LeftistTachyon/BinauralMic/README.md

# Tachi's Homemade Binaural Mic
More to come soon!  
(I barely have a schematic atm lol)
