LeftistTachyon/BinauralMic/binauralmic.3dmodels/2-1977223-4.stp

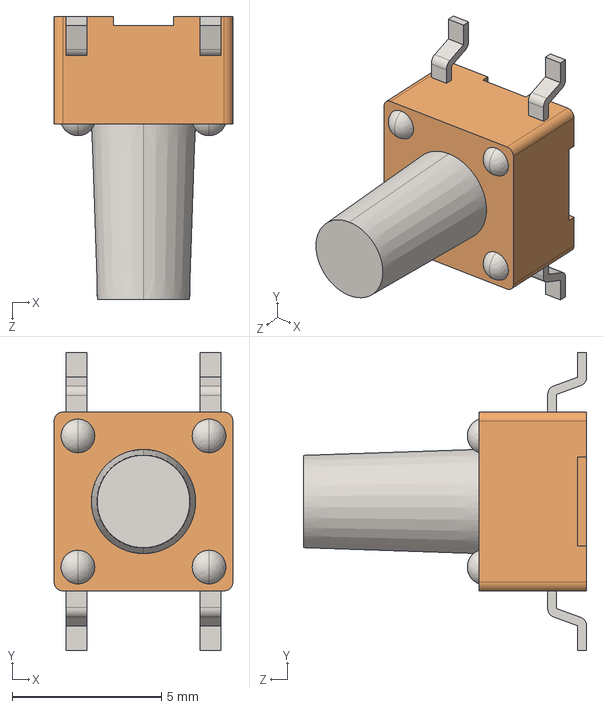
[picture p1: CAD file, 2025-07-08]
binauralmic.3dmodels/2-1977223-4.stp
6.00 x 10.0 x 9.51 mm
