LeftistTachyon/BinauralMic/BinauralMic.step

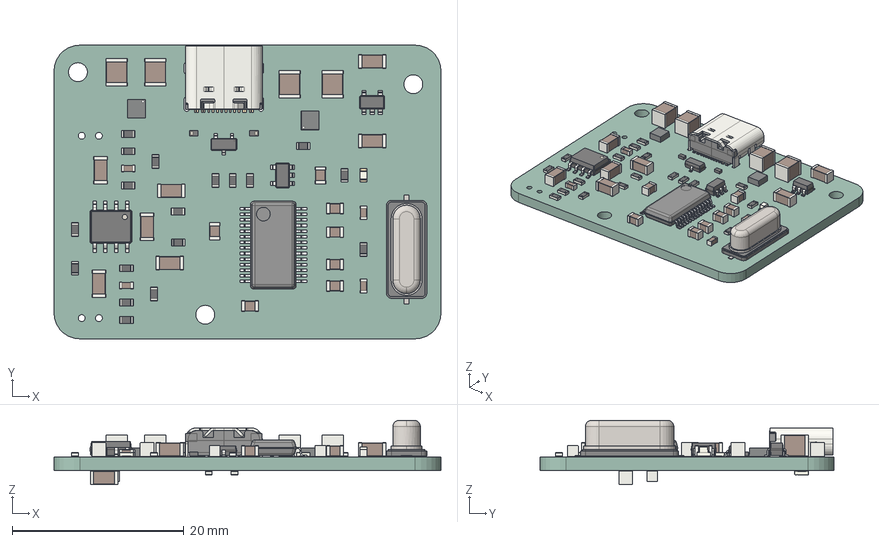
[picture p2: CAD file, 2024-10-13]
BinauralMic.step
45.0 x 34.2 x 7.50 mm
ABLS-12.000MHZ-B4-T
C_1206_3216Metric x 8
C_0805_2012Metric x 8
C_0603_1608Metric x 4
R_0603_1608Metric x 20
C_1210_3225Metric x 4
SOT_23_5 x 2
SOIC_8_39x49mm_P127mm
Coilcraft-XFL2010 x 2
LED_0603_1608Metric
D_SOD-882 x 2
USB_C_Receptacle_16P_TopMnt_Horizontal_GCT_USB4105-xx-A
DB0028A_ASM
SOT-23-3
BinauralMic_PCB
