LeftistTachyon/BinauralMic/binauralmic.3dmodels/ABLS-12.000MHz-20-D-3-H-T.stp

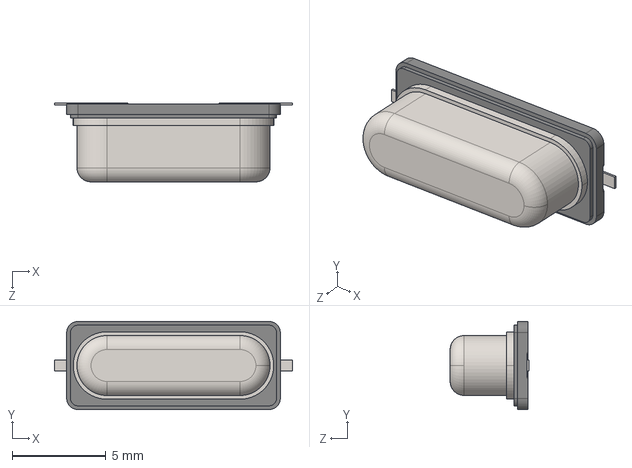
[picture p3: CAD file, 2024-09-22]
binauralmic.3dmodels/ABLS-12.000MHz-20-D-3-H-T.stp
12.7 x 4.70 x 4.20 mm
