LeftistTachyon/BinauralMic/binauralmic.3dmodels/CUI_DEVICES_RCJ-014.step

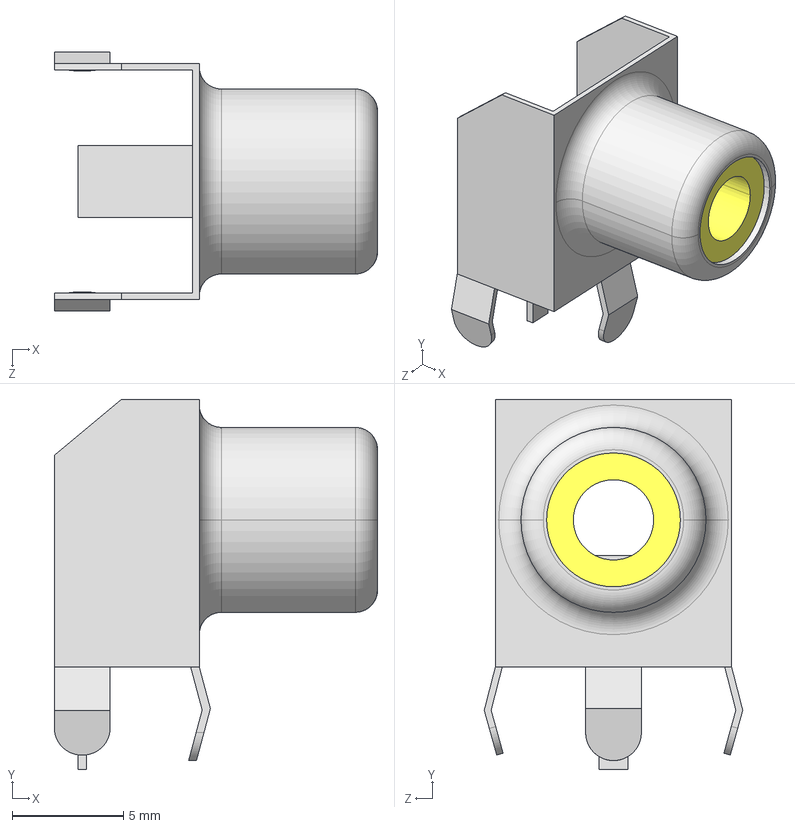
[picture p4: CAD file, 2024-09-21]
binauralmic.3dmodels/CUI_DEVICES_RCJ-014.step
14.5 x 16.6 x 11.6 mm
