LeftistTachyon/BinauralMic/binauralmic.3dmodels/Coilcraft-XFL2010.step

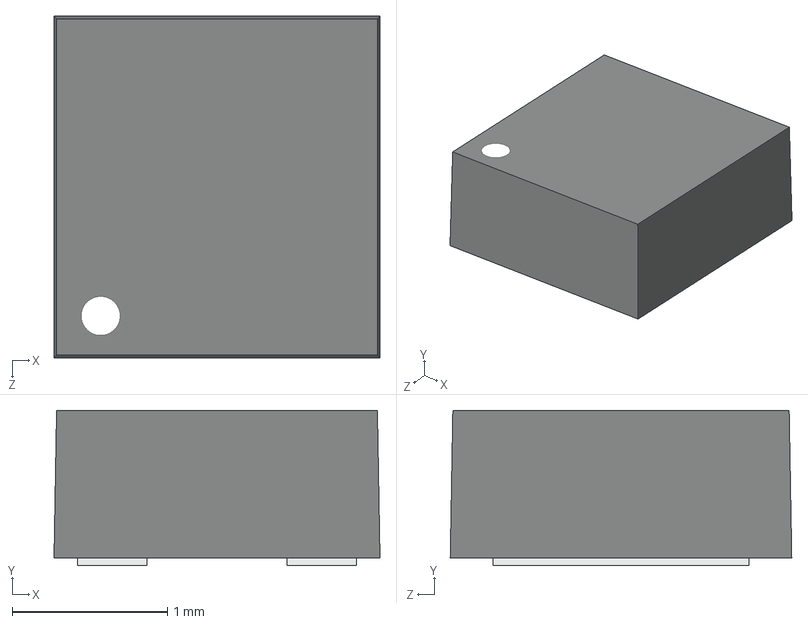
[picture p5: CAD file, 2024-09-16]
binauralmic.3dmodels/Coilcraft-XFL2010.step
2.10 x 1.00 x 2.20 mm
