LeftistTachyon/BinauralMic/binauralmic.3dmodels/P140KH1-Y20AR20K.stp

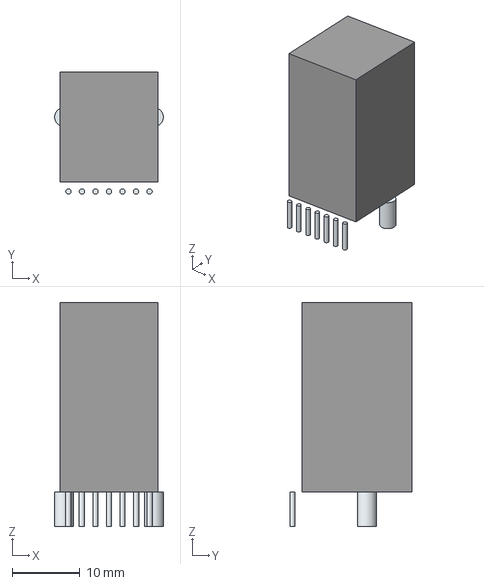
[picture p6: CAD file, 2024-09-16]
binauralmic.3dmodels/P140KH1-Y20AR20K.stp
16.1 x 18.1 x 33.1 mm
Leads
