LeftistTachyon/BinauralMic/binauralmic.3dmodels/MX1A-11NW.stp

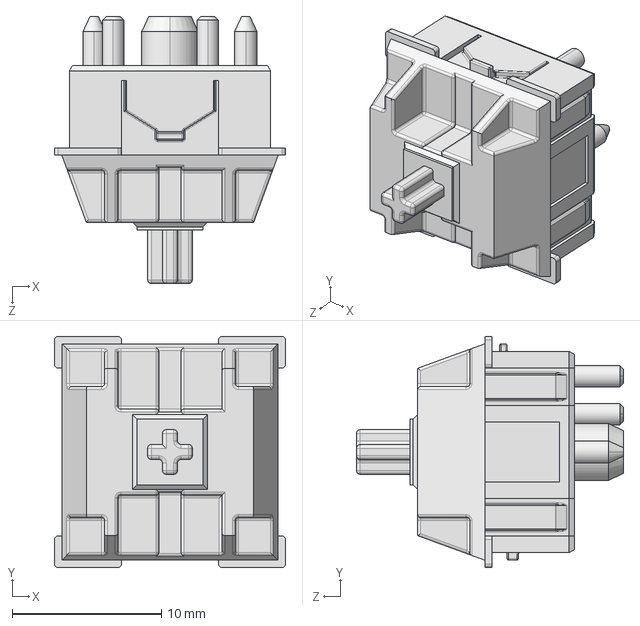
[picture p7: CAD file, 2024-09-15]
binauralmic.3dmodels/MX1A-11NW.stp
15.5 x 15.5 x 17.9 mm
