LeftistTachyon/BinauralMic/binauralmic.3dmodels/ECS-120-8-36-CKM-TR3.stp

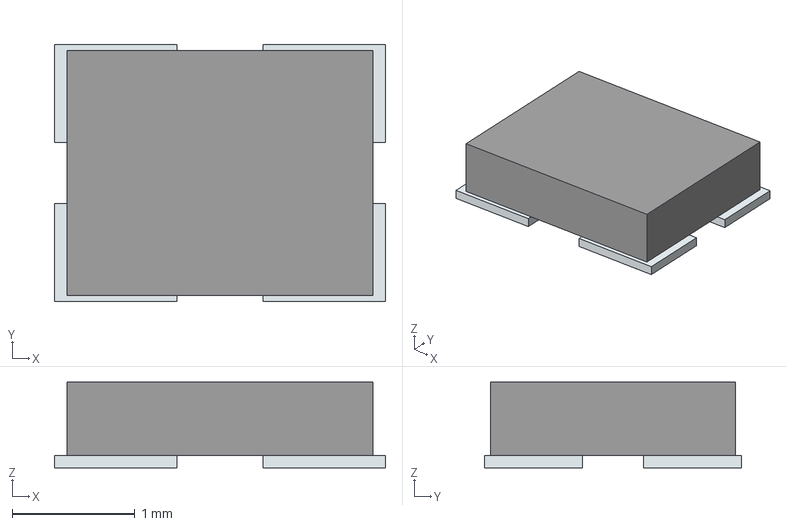
[picture p8: CAD file, 2024-09-13]
binauralmic.3dmodels/ECS-120-8-36-CKM-TR3.stp
2.70 x 2.10 x 0.7 mm
Pins
