LeftistTachyon/BinauralMic/binauralmic.3dmodels/PCM2903CDBR.stp

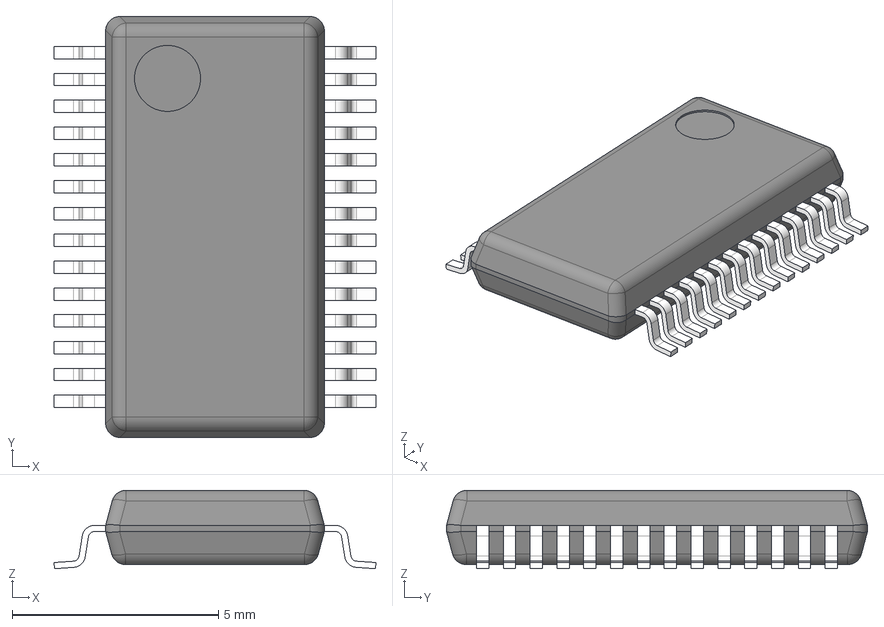
[picture p9: CAD file, 2024-09-13]
binauralmic.3dmodels/PCM2903CDBR.stp
7.80 x 10.2 x 1.90 mm
BODY-SSOP
LEAD-SSOP x 28
PIN1
