LeftistTachyon/BinauralMic/sim/Preamp2.asc

C1: cap; 68p
C2: cap; 4.7µ; Rser={ESR}
C3: cap; 4.7µ
C4: cap; 4.7µ; Rser={ESR}
I1: current; SINE(0.5m 28.68e-6 1k); AC 28.68e-6
R1: res; {Rpot}
R2: res; 1Meg
R3: res; 49.9
R4: res; 100k
R5: res; 100k
R6: res; 100k
R7: res; 11.111k
R8: res; 2.2k
R9: res; 5.9k
R10: res; 1m
U1: UniversalOpAmp2
V1: voltage; 3.3
V2: voltage; 5
Named nets: 0, 3V3, VB, IN, N, O, OUT
.ac dec 1k 2 200Meg
.tran 10m
.noise V(OUT) I1 dec 1k 2 200k
;.step param ESR list 0 4
.param ESR=4
.step param Rpot 1 20k 2k
