LeftistTachyon/BinauralMic/sim/InputFilter.asc

C1: cap; 22µ
C2: cap; 23µ
L1: ind; 47µ; Rser=2.53
V1: voltage; ""; AC 1
Named nets: 0, IN, OUT
.ac dec 1k 47k 49k
