LeftistTachyon/BinauralMic/sim/Preamp.asc

C1: cap; 330p
C2: cap; 0.0018µ
C3: cap; 10µ
C4: cap; 10µ
R1: res; 3.9k
R2: res; 12k
R3: res; 12k
R4: res; 100
R5: res; {Rin}
U1: UniversalOpAmp2
V1: voltage; PULSE(0 3.3 100u 10u 10u 200u 500u 2); AC 1
V2: voltage; 3.3
V3: voltage; 1.65
Named nets: 0, 3V3, IN, OUT, OUT_RAW, IN_RAW, N1, N2, N3
.ac dec 1k 10 10Meg
.ac dec 1k 0.1 1k
;.step param Rin list 10 1k 10k 100k
.param Rin=1Meg
.tran 1m
