LeftistTachyon/BinauralMic/BinauralMic.kicad_pcb

## KiCad design BinauralMic.kicad_pcb (2025-07-08)

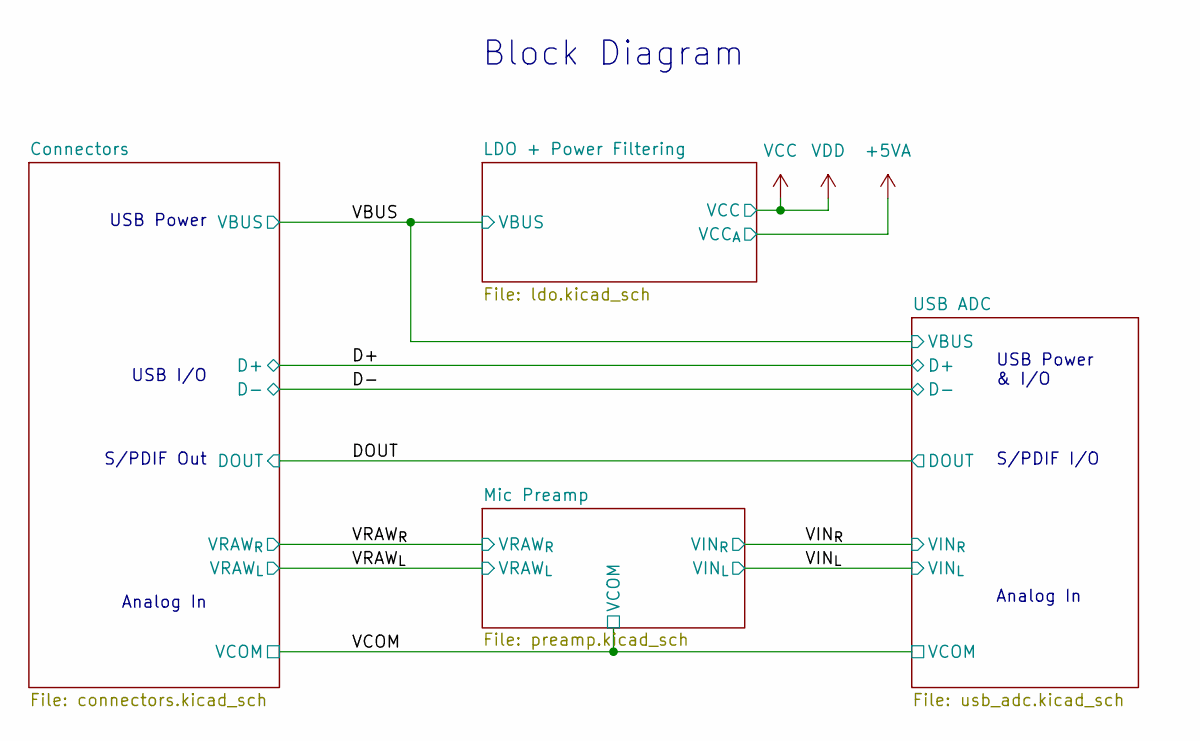
[picture p10: schematic BinauralMic.kicad_sch, Binaural Mic (Block Diagram)]

Notes on the sheet:
Analog In
USB Power
S/PDIF I/O
USB I/O
USB Power & I/O
S/PDIF Out
Block Diagram

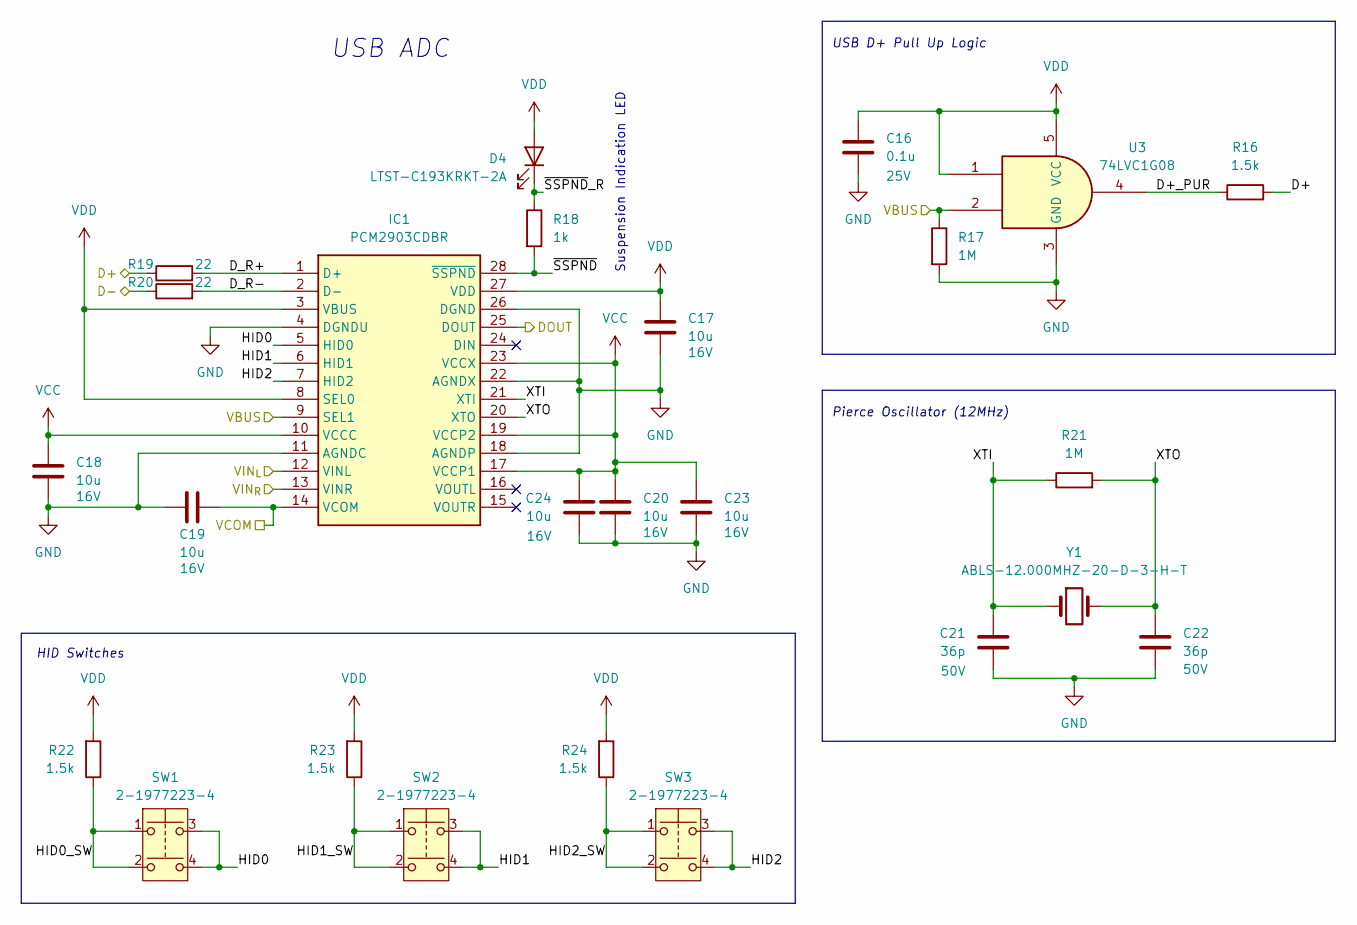
[picture p11: schematic usb_adc.kicad_sch, USB ADC]

Parts:
C16: 0.1u; C_0603_1608Metric_Pad1.08x0.95mm_HandSolder; Voltage Rating 25V; Mouser Part Number 187-CL10A104KA8NNNC
C17, C18, C19, C20, C23, C24: 10u; C_1206_3216Metric_Pad1.33x1.80mm_HandSolder; Voltage Rating 16V; Mouser Part Number 581-TAJA106K016R
C21, C22: 36p; C_0603_1608Metric_Pad1.08x0.95mm_HandSolder; Voltage Rating 50V; Mouser Part Number 603-CC603FRNPO9BN360
D4: LTST-C193KRKT-2A; LED_0603_1608Metric_Pad1.05x0.95mm_HandSolder; Mouser Part Number 859-LTST-C193KRKT-2A
IC1: PCM2903CDBR; SOP65P780X200-28N; Mouser Part Number 595-PCM2903CDBR
R16, R22, R23, R24: 1.5k; R_0603_1608Metric_Pad0.98x0.95mm_HandSolder; Mouser Part Number 667-ERA-3AEB152V
R17, R21: 1M; R_0603_1608Metric_Pad0.98x0.95mm_HandSolder; Mouser Part Number 652-CR0603FX-1004ELF
R18: 1k; R_0603_1608Metric_Pad0.98x0.95mm_HandSolder; Mouser Part Number 71-CRCW06031K00FKEE
R19, R20: 22; R_0603_1608Metric_Pad0.98x0.95mm_HandSolder; Mouser Part Number 652-CR0603FX-22R0ELF
SW1, SW2, SW3: 2-1977223-4; 219772234
U3: 74LVC1G08; SOT-23-5_HandSoldering; Mouser Part Number 771-74LVC1G08GV
Y1: ABLS-12.000MHZ-20-D-3-H-T; ABLS; Mouser Part Number 815-LS12000MHZ20D3HT

Connections:
/D+: R16.2, R19.1; also elsewhere on the board
/D-: R20.1; also elsewhere on the board
/DOUT: IC1.25 (DOUT)
/USB ADC/D+_PUR: R16.1, U3.4
/USB ADC/D_R+: IC1.1 (D+), R19.2
/USB ADC/D_R-: IC1.2 (D-), R20.2
/USB ADC/HID0: IC1.5 (HID0), SW1.3, SW1.4
/USB ADC/HID0_SW: R22.1, SW1.1, SW1.2
/USB ADC/HID1: IC1.6 (HID1), SW2.3, SW2.4
/USB ADC/HID1_SW: R23.1, SW2.1, SW2.2
/USB ADC/HID2: IC1.7 (HID2), SW3.3, SW3.4
/USB ADC/HID2_SW: R24.1, SW3.1, SW3.2
/USB ADC/XTI: C21.1, IC1.21 (XTI), R21.1, Y1.1
/USB ADC/XTO: C22.1, IC1.20 (XTO), R21.2, Y1.2
/USB ADC/~SSPND: IC1.28 (~SSPND), R18.2
/USB ADC/~SSPND_R: D4.1 (K), R18.1
/VBUS: IC1.9 (SEL1), R17.1, U3.2; also elsewhere on the board
/VCOM: C19.2, IC1.14 (VCOM); also elsewhere on the board
/VIN_{L}: IC1.12 (VINL); also elsewhere on the board
/VIN_{R}: IC1.13 (VINR); also elsewhere on the board
GND: C16.1, C17.2, C18.2, C19.1, C20.2, C21.2, C22.2, C23.2, C24.2, IC1.4 (DGNDU), IC1.11 (AGNDC), IC1.18 (AGNDP), IC1.22 (AGNDX), IC1.26 (DGND), R17.2, U3.3 (GND); also elsewhere on the board

Notes on the sheet:
USB ADC
HID Switches
Pierce Oscillator (12MHz)
USB D+ Pull Up Logic
Suspension Indication LED

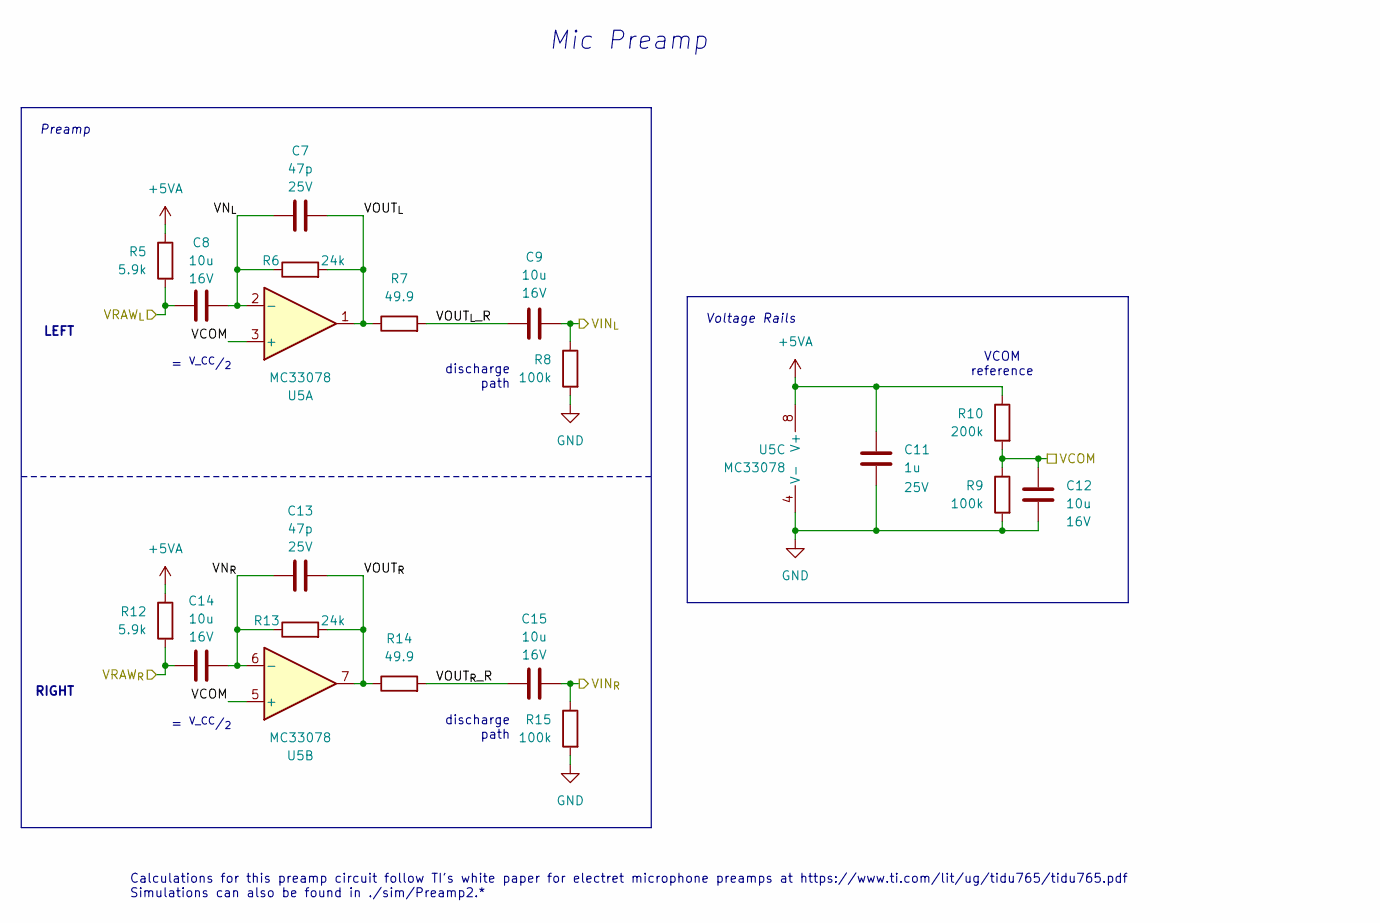
[picture p12: schematic preamp.kicad_sch, Microphone Preamplifier]

Parts:
C7, C13: 47p; C_0603_1608Metric_Pad1.08x0.95mm_HandSolder; Voltage Rating 25V; Mouser Part Number 77-VJ0603A470JXXCBC
C8, C9, C12, C14, C15: 10u; C_1206_3216Metric_Pad1.33x1.80mm_HandSolder; Voltage Rating 16V; Mouser Part Number 581-TAJA106K016R
C11: 1u; C_0603_1608Metric_Pad1.08x0.95mm_HandSolder; Voltage Rating 25V; Mouser Part Number 187-CL10B105KA8NNNL
R5, R12: 5.9k; R_0603_1608Metric_Pad0.98x0.95mm_HandSolder; Mouser Part Number 667-ERA-3AEB5901V
R6, R13: 24k; R_0603_1608Metric_Pad0.98x0.95mm_HandSolder; Mouser Part Number 03-RT0603DRD0724KL
R7, R14: 49.9; R_0603_1608Metric_Pad0.98x0.95mm_HandSolder; Mouser Part Number 791-RMC1/16K49R9FTP
R8, R9, R15: 100k; R_0603_1608Metric_Pad0.98x0.95mm_HandSolder; Mouser Part Number 603-RT0603FRE10100KL
R10: 200k; R_0603_1608Metric_Pad0.98x0.95mm_HandSolder; Mouser Part Number 603-AF0603FR-07200KL
U5: MC33078; SOIC-8_3.9x4.9mm_P1.27mm; Mouser Part Number 863-MC33078DR2G

Connections:
+5VA: C11.1, R5.1, R10.1, R12.1, U5.8 (V+); also elsewhere on the board
/Mic Preamp/VN_{L}: C7.1, C8.2, R6.1, U5.2 (-)
/Mic Preamp/VN_{R}: C13.1, C14.2, R13.1, U5.6 (-)
/Mic Preamp/VOUT_{L}: C7.2, R6.2, R7.1, U5.1
/Mic Preamp/VOUT_{L}_R: C9.1, R7.2
/Mic Preamp/VOUT_{R}: C13.2, R13.2, R14.1, U5.7
/Mic Preamp/VOUT_{R}_R: C15.1, R14.2
/VCOM: C12.2, R9.1, R10.2, U5.3 (+), U5.5 (+); also elsewhere on the board
/VIN_{L}: C9.2, R8.1; also elsewhere on the board
/VIN_{R}: C15.2, R15.1; also elsewhere on the board
/VRAW_{L}: C8.1, R5.2; also elsewhere on the board
/VRAW_{R}: C14.1, R12.2; also elsewhere on the board
GND: C11.2, C12.1, R8.2, R9.2, R15.2, U5.4 (V-); also elsewhere on the board

Notes on the sheet:
RIGHT
= ^{V_CC}/_{2}
LEFT
Mic Preamp
discharge path
VCOM reference
Calculations for this preamp circuit follow TI's white paper for electret microphone preamps at https://www.ti.com/lit/ug/tidu765/tidu765.pdf Simulations can also be found in ./sim/Preamp2.*
Voltage Rails
Preamp

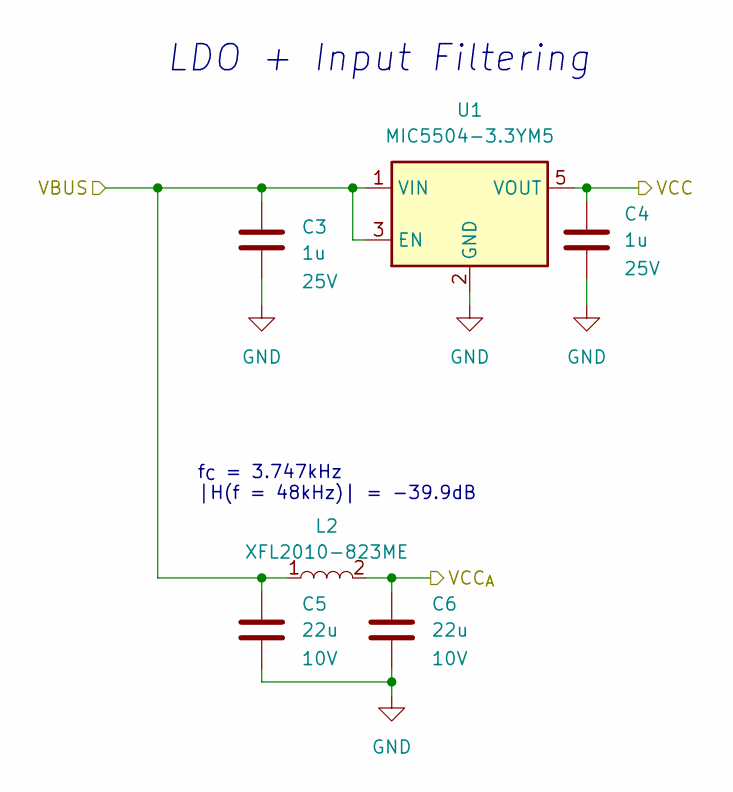
[picture p13: schematic ldo.kicad_sch, LDO + Power Filtering]

Parts:
C3, C4: 1u; C_0603_1608Metric_Pad1.08x0.95mm_HandSolder; Voltage Rating 25V; Mouser Part Number 187-CL10B105KA8NNNL
C5, C6: 22u; C_0805_2012Metric_Pad1.18x1.45mm_HandSolder; Voltage Rating 10V; Mouser Part Number 187-CL21A226MPQNNNE
L2: XFL2010-823ME; L_Coilcraft_XFL2010
U1: MIC5504-3.3YM5; SOT-23-5_HandSoldering; Mouser Part Number 998-MIC5504-3.3YM5TR

Connections:
+5VA: C6.1, L2.2; also elsewhere on the board
/VBUS: C3.1, C5.1, L2.1, U1.1 (VIN), U1.3 (EN); also elsewhere on the board
GND: C3.2, C4.2, C5.2, C6.2, U1.2 (GND); also elsewhere on the board

Notes on the sheet:
f_{C} = 3.747kHz |H(f = 48kHz)| = -39.9dB
LDO + Input Filtering

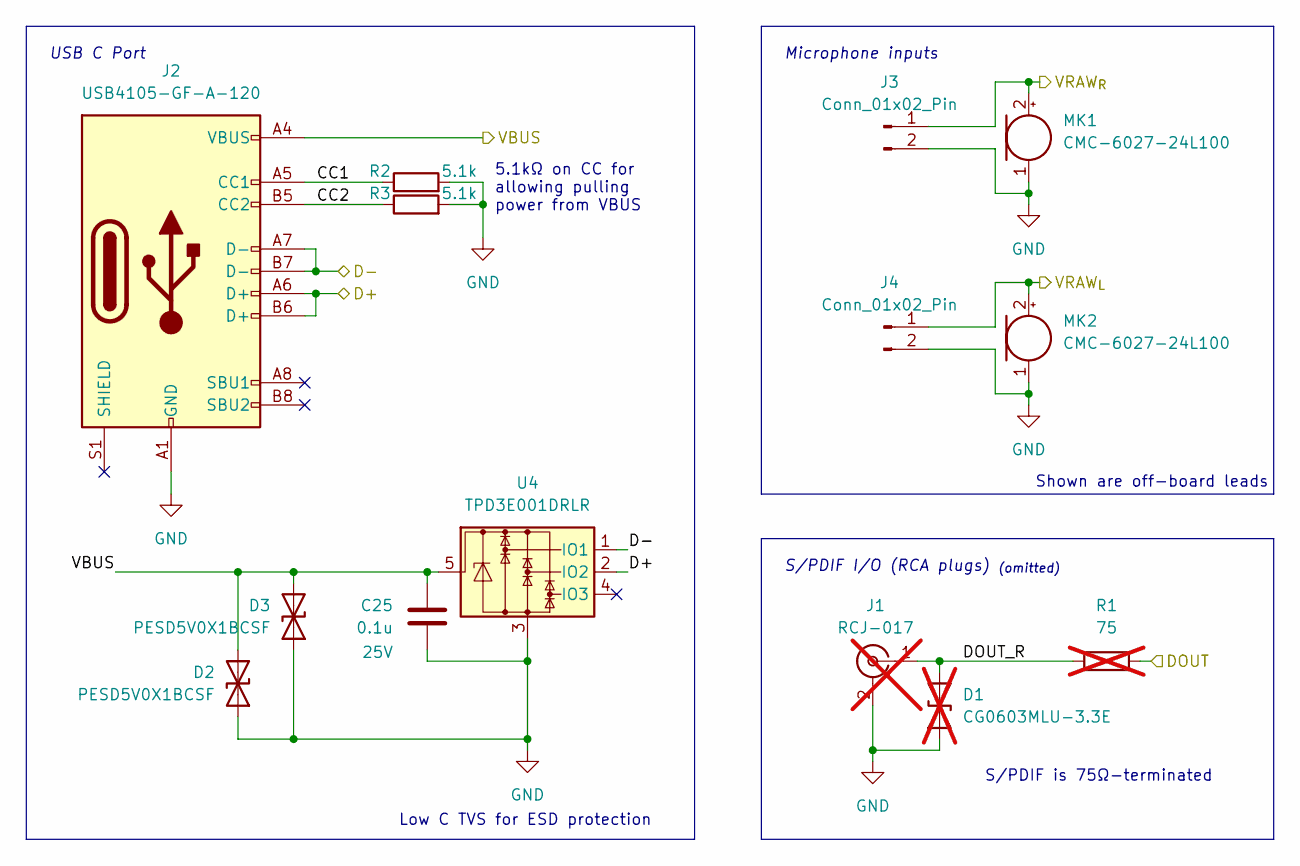
[picture p14: schematic connectors.kicad_sch]

Parts:
C25: 0.1u; C_0603_1608Metric_Pad1.08x0.95mm_HandSolder; Voltage Rating 25V; Mouser Part Number 187-CL10A104KA8NNNC
D1: CG0603MLU-3.3E; D_0603_1608Metric_Pad1.05x0.95mm_HandSolder; Mouser Part Number 652-CG0603MLU-3.3E; not fitted
D2, D3: PESD5V0X1BCSF; D_0603_1608Metric_Pad1.05x0.95mm_HandSolder; Mouser Part Number 771-PESD5V0X1BCSFYL
J1: RCJ-017; RCJ014; Mouser Part Number 490-RCJ-017; not fitted
J2: USB4105-GF-A-120; USB_C_Receptacle_GCT_USB4085; Mouser Part Number 640-USB4085-GF-A
J3, J4: Conn_01x02_Pin; PinHeader_1x02_P2.00mm_Vertical
MK1, MK2: CMC-6027-24L100; Mouser Part Number 490-CMC-6027-24L100
R1: 75; R_0603_1608Metric_Pad0.98x0.95mm_HandSolder; Mouser Part Number 603-RT0603FRE0775RL; not fitted
R2, R3: 5.1k; R_0603_1608Metric_Pad0.98x0.95mm_HandSolder; Mouser Part Number 603-RC0603FR-105K1L
U4: TPD3E001DRLR; SOT-553; Mouser Part Number 595-TPD3E001DRLR

Connections:
/Connectors/CC1: J2.A5 (CC1), R2.1
/Connectors/CC2: J2.B5 (CC2), R3.1
/D+: J2.A6 (D+), J2.B6 (D+), U4.2 (IO2); also elsewhere on the board
/D-: J2.A7 (D-), J2.B7 (D-), U4.1 (IO1); also elsewhere on the board
/VBUS: C25.2, D2.2 (A2), D3.2 (A2), J2.A4 (VBUS), J2.A9 (VBUS), J2.B4 (VBUS), J2.B9 (VBUS), U4.5; also elsewhere on the board
/VRAW_{L}: J4.1, MK2.2 (+); also elsewhere on the board
/VRAW_{R}: J3.1, MK1.2 (+); also elsewhere on the board
GND: C25.1, D1.1 (A1), D2.1 (A1), D3.1 (A1), J1.2 (Ext), J2.A1 (GND), J2.A12 (GND), J2.B1 (GND), J2.B12 (GND), J3.2, J4.2, MK1.1 (-), MK2.1 (-), R2.2, R3.2, U4.3; also elsewhere on the board
unnamed: D1.2 (A2), J1.1 (In), R1.2

Notes on the sheet:
USB C Port
S/PDIF is 75Ω-terminated
Shown are off-board leads
Microphone inputs
S/PDIF I/O (RCA plugs) _{(omitted)}
5.1kΩ on CC for allowing pulling power from VBUS
Low C TVS for ESD protection

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
Board: 2 copper layers, 59 parts (0 on the bottom side), 32 nets, no tracks yet.
