LeftistTachyon/BinauralMic/(commit log)

2024-09-13 Add project files
    [156-4218-E.stp, BinauralMic.kicad_pcb, BinauralMic.kicad_sch, ECS-120-8-36-CKM-TR3.stp, PCM2903CDBR.stp]
2024-09-13 Add USB port
    [BinauralMic.kicad_sch]
2024-09-14 Added input filter
    LTSpice simulation to come soon
    [BinauralMic.kicad_sch]
2024-09-14 Adding input filter LTSpice simulation file
2024-09-14 Add various things
    [BinauralMic.kicad_sch]
2024-09-15 Add simulations and new op amp preamp
    And hand calcs
    [BinauralMic.kicad_sch]
2024-09-15 Copy the correct values from the hand calcs & copy to simulations
    [BinauralMic.kicad_sch]
2024-09-15 Reorganized schematic
    Should be much cleaner now
    And added a random shunt resistor to measure current coming out of Op Amp (should be ok)
    [BinauralMic.kicad_sch, connectors.kicad_sch, ldo.kicad_sch, preamp.kicad_sch, usb_adc.kicad_sch]
2024-09-15 Save unchanged changes
    [connectors.kicad_sch, ldo.kicad_sch, preamp.kicad_sch, usb_adc.kicad_sch]
2024-09-15 Resnap text to grid + add .gitignore
    [BinauralMic.kicad_sch, connectors.kicad_sch, ldo.kicad_sch, preamp.kicad_sch, usb_adc.kicad_sch]
2024-09-15 Started defining components
    Man going down the capacitor dielectric rabbit hole eats up SO MUCH TIME
    [connectors.kicad_sch, ldo.kicad_sch, preamp.kicad_sch, usb_adc.kicad_sch]
2024-09-15 Fully define components
    [connectors.kicad_sch, ldo.kicad_sch, preamp.kicad_sch, usb_adc.kicad_sch]
2024-09-15 Replace S/PIDF RCA jack with a singular one since I won't need an input one
    [156-4218-E.stp, BinauralMic.kicad_sch, MX1A-11NW.stp, RCJ-014.stp, connectors.kicad_sch, usb_adc.kicad_sch]
2024-09-16 Removing extraneous peripherals
    [usb_adc.kicad_sch]
2024-09-16 Add analog volume control
    [P140KH1-Y20AR20K.stp, connectors.kicad_sch, ldo.kicad_sch, preamp.kicad_sch]
2024-09-16 Remove potentiometer
    Will have to find a different solution for volume control
    Just do it OS-side?
    [BinauralMic.kicad_pcb, connectors.kicad_sch, ldo.kicad_sch, preamp.kicad_sch, usb_adc.kicad_sch]
2024-09-16 Starting layout
    Also why are the mf diodes so small
    [BinauralMic.kicad_pcb, BinauralMic.kicad_sch, Coilcraft-XFL2010.step, connectors.kicad_sch, ldo.kicad_sch, preamp.kicad_sch, usb_adc.kicad_sch]
2024-09-17 Started layout?
    [BinauralMic.kicad_pcb]
2024-09-21 Replace 0201 diodes with recommended arrays and nothing (some were spurious and I think I don't need them)
    [connectors.kicad_sch, ldo.kicad_sch, preamp.kicad_sch]
2024-09-21 Reannotated schematic + restarted layout
    woohoo
    [BinauralMic.kicad_pcb, connectors.kicad_sch, ldo.kicad_sch, preamp.kicad_sch, usb_adc.kicad_sch]
2024-09-21 Add more detailed RCJ-014 model + shifting things around
    Also added another ESD diode for VBUS because only one will be connected for USB C :/
    [BinauralMic.kicad_pcb, CUI_DEVICES_RCJ-014.step, RCJ-014.stp, connectors.kicad_sch]
2024-09-21 Removed S/PIDF and still doing layout
    [BinauralMic.kicad_pcb, connectors.kicad_sch, usb_adc.kicad_sch]
2024-09-22 More layout, replaced chip crystal with a 2-pin oscillator
    All is well with the world
    [ABLS-12.000MHz-20-D-3-H-T.stp, BinauralMic.kicad_pcb, BinauralMic.kicad_sch, ldo.kicad_sch, preamp.kicad_sch, usb_adc.kicad_sch]
2024-09-22 Layout changes
    See previous commit
    I forgot to save lol
    [BinauralMic.kicad_pcb]
2024-09-22 Did a lot of layout
    [BinauralMic.kicad_pcb]
2024-09-22 Flipped inductor direction (dot towards EMI) and shuffled some components around
    Hopefully a more rested me can fit this jigsaw a little better
    [BinauralMic.kicad_pcb, ldo.kicad_sch]
2024-10-03 Layout + routing for preamp
    [BinauralMic.kicad_pcb]
2024-10-04 Finished routing
    [BinauralMic.kicad_pcb, usb_adc.kicad_sch]
2024-10-05 Passing review from @MorrisYLin
    Thank you for looking everything over!
    [BinauralMic.kicad_pcb]
2024-10-06 Add silkscreen + some bonus test points
    [BinauralMic.kicad_pcb, usb_adc.kicad_sch]
2024-10-06 Fix pierce osc load caps
    [usb_adc.kicad_sch]
2024-10-13 Add step file
    [BinauralMic.step]
2025-07-04 Update to KiCAD 9.0
    [BinauralMic.kicad_sch, connectors.kicad_sch, ldo.kicad_sch, preamp.kicad_sch, usb_adc.kicad_sch]
2025-07-06 Redid schematic and component values according to new recalculations
    [BinauralMic.kicad_pcb, BinauralMic.kicad_sch, BinauralMic_old.kicad_pcb, connectors.kicad_sch, ldo.kicad_sch, preamp.kicad_sch, usb_adc.kicad_sch]
2025-07-08 Add buttons for device control + various other changes
    [2-1977223-4.stp, BinauralMic.kicad_pcb, connectors.kicad_sch, preamp.kicad_sch, usb_adc.kicad_sch]
